Carrot-collective/ERCF_v3/STLs/6._Selector/Servo_Options/Servo_Mount_DS041MG_v3.stl

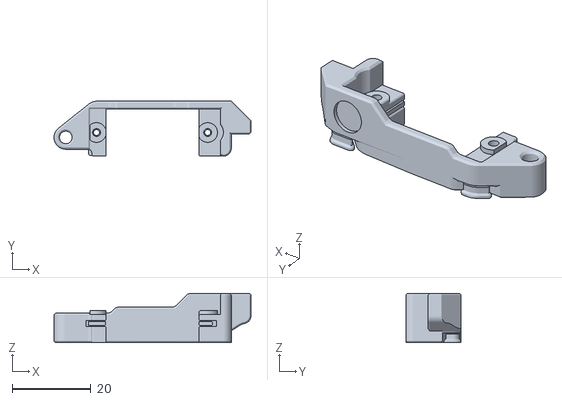
[picture p1: CAD file, 2026-08-23]
STLs/6._Selector/Servo_Options/Servo_Mount_DS041MG_v3.stl
50.0 x 14.0 x 12.5
