Carrot-collective/ERCF_v3/(commit log)

2026-08-19 Create ERCF_Manual_08-19-26.pdf
    Updated Binky wiring
2026-08-23 Update DS041MG Mount
    Thanks to puffymania.
    [Servo_Mount_DS041MG_v2.stl, Servo_Mount_DS041MG_v3.stl]
